chunshar/cool642tb-case2/README.md

# cool642tb-case2

m.ki (@0002ozlet) 様が設計・販売している自作キーボードキット[cool642tb](https://booth.pm/ja/items/6740910 "BOOTH")用のシンプルなケースの試作2号機です。






tadpoleマウントによる柔らかな打鍵感と、それを生かすためのややどっしりとした作りが特徴です。\
薄さを目指した試作1号機とは逆に結構な厚みと大きさがありますが、持ち運び可能なサイズ感には収まっていると思います。\
MXスイッチにもchocスイッチにも対応可能です。

なお、最近電池ケースが変更されてマイコンが横向きに付いているr2基板が登場しましたが、このケースは対応していません。\
電池ケースが入荷されたらr1基板も並行して頒布再開されるようですので、再開を待ちましょう。

## 使い方

- 自前の3Dプリンタで造形するか、3Dプリントサービスに発注するなどしてください。どのパーツもインフィルを多めにして頑丈にした方が良いかも。
- トラックボールケースは試作1号機と同様に、ダイソーのミニサイズのマグネットをはめ込んでくっつける想定です。
- tadpoleを8個（左右4個ずつ）用意してください。\
  [Greenkeys Shop](https://shop.green-keys.info/products/tadpole "GREENKEYS")様で販売しています。
- 電池ケースはビルドガイドとは逆にPCBの裏側に取り付けてください。
  リード線を2～3cmくらいの長さを残して切断して皮をむき、PCBの裏側から穴に通して表側ではんだ付けしてください。\
  多少ぶらんとした感じになりますが、両面テープで固定しなくても特に問題ありません。ある程度の余長がある方が良いです。
- リセットスイッチ付きの基板の場合は、リセットスイッチは表側に取り付けてください（オプションなのでなくてもよい）。
- MXのキースイッチを使う場合は、M2x3mmのスペーサーをPCBの裏からネジ留めしてプレートを支えるようにしてからキースイッチをはめます。
  間にフォームを挟むのもお勧めです。\
  chocスイッチの場合はスペーサーはなしでPCBにプレートを重ねてそのままキースイッチをはめます。
- プレートの上下にある4か所の輪にtadpoleを下側から挿し込んでボトムケース外周の窪みに置いてください。\
  この時、底面に2mm程度のポロンシートなど柔らかい材質の消音シートを敷いても良いでしょう。
- 上からトップケースをはめてください。\
  トップケースの爪は簡単には折れませんので、奥側→手前側の順に思い切ってガシガシはめて問題ありません。\
  特に右手側の左手前の辺りがはめづらいかもしれませんが、ちょっと引っ張ったりして気にせずググっと押し込めば行けます。\
  tadpoleがトップケースの穴に入るようにまっすぐはめてください。\
  外すときも、ビビらずに思い切ってやりましょう。大体大丈夫です。
- PCBにトラボ基盤を挿してトラボケースをくっつけ、左右のスライドスイッチにつまみを挿し込んだら完成です。\
  ケースをつける前にスライドスイッチのつまみを一度抜き差ししておくと、ケースをつけた後にはめやすくなります。
- オートマウスレイヤがONの場合、トラボ周辺のキーを押すと振動で間違いなく誤爆しますので、AMLをオフにしてファームを作り直すのが吉です。

## その他注意事項

STEPファイルにしましたので、3D CADソフトなどでお好きに改造してご利用ください。\
ただし、そのまま販売したりするのはおやめください。

このケースを使ったことによるいかなる損害も責任は負いません。自分で何とかしてください。
