chunshar/cool642tb-case2/cool642tb-case2_switch.step

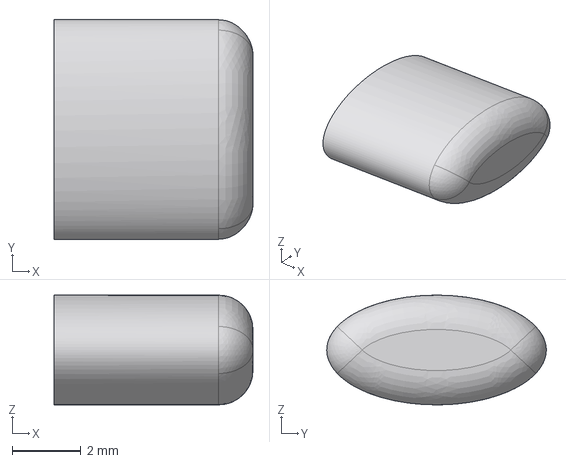
[picture p1: CAD file, 2025-08-03]
cool642tb-case2_switch.step
5.80 x 6.40 x 3.20 mm
