chunshar/cool642tb-case2/cool642tb-case2-R-plate.step

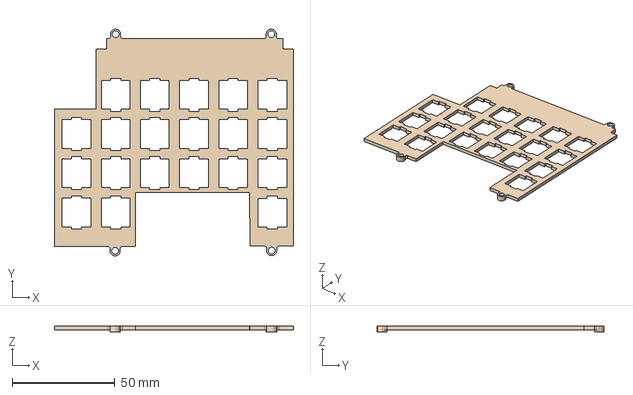
[picture p2: CAD file, 2025-08-03]
cool642tb-case2-R-plate.step
116.2 x 110.3 x 3.00 mm
