chunshar/cool642tb-case2/cool642tb-case2-trackballcase.step

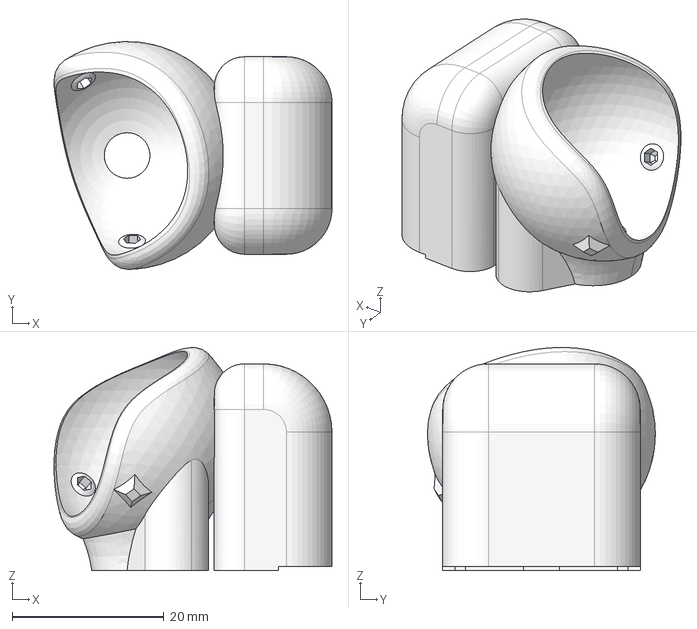
[picture p3: CAD file, 2025-08-03]
cool642tb-case2-trackballcase.step
36.6 x 30.0 x 29.4 mm
