chunshar/cool642tb-case2/cool642tb-case2-L-bottom.step

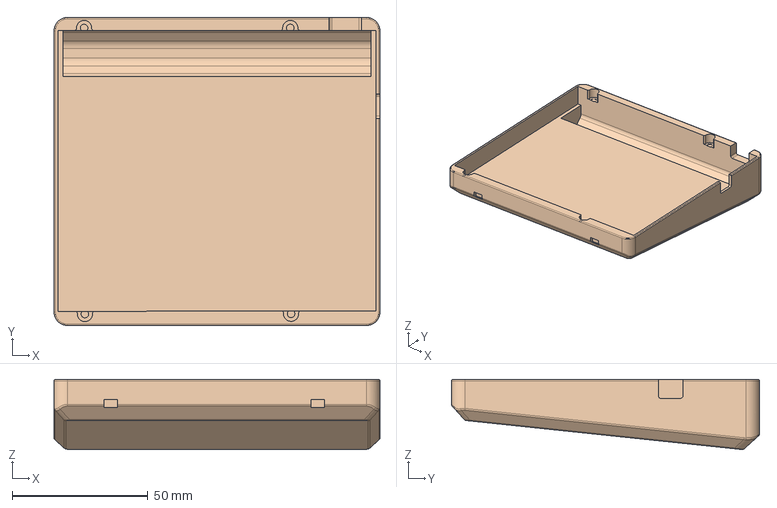
[picture p4: CAD file, 2025-08-03]
cool642tb-case2-L-bottom.step
120.2 x 113.6 x 25.9 mm
