chunshar/cool642tb-case2/cool642tb-case2-L-top.step

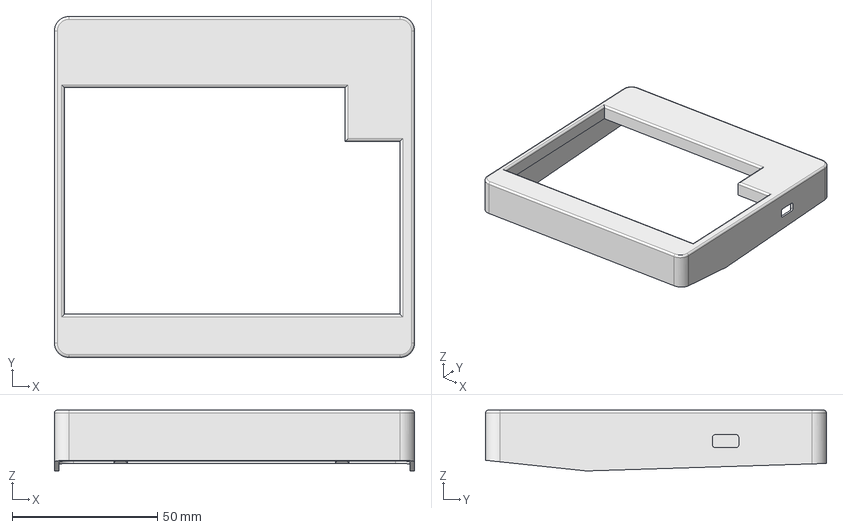
[picture p5: CAD file, 2025-08-03]
cool642tb-case2-L-top.step
124.2 x 117.6 x 21.0 mm
