chunshar/cool642tb-case2/cool642tb-case2-R-bottom.step

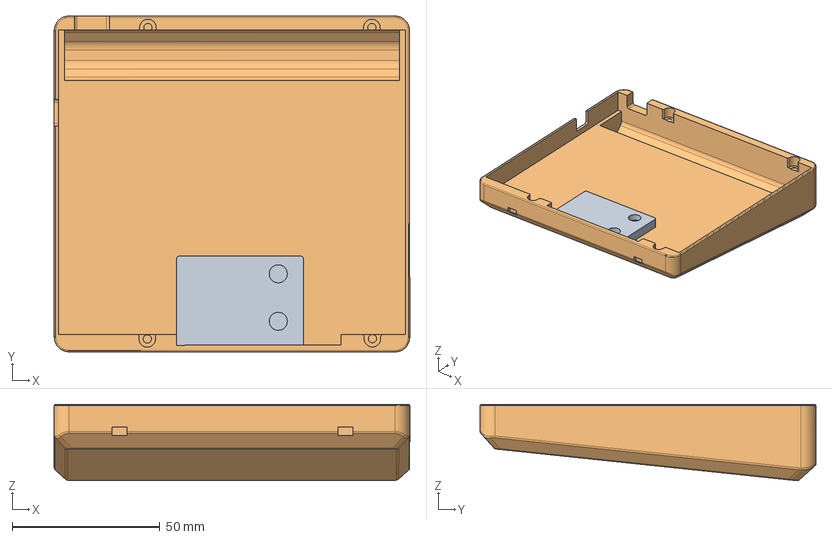
[picture p6: CAD file, 2025-08-03]
cool642tb-case2-R-bottom.step
120.2 x 113.6 x 25.9 mm
