chunshar/cool642tb-case2/cool642tb-case2-L-plate.step

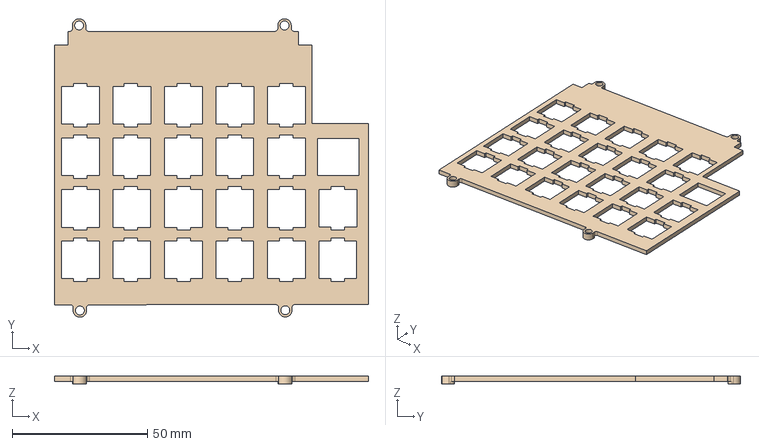
[picture p7: CAD file, 2025-08-03]
cool642tb-case2-L-plate.step
116.2 x 110.4 x 3.00 mm
