chunshar/cool642tb-case2/(list of files, cad)

Other CAD files:
cool642tb-case2-R-top.step
